stefany-florez/surface-emg-research/README.md

# Surface EMG acquisition and signal analysis

## Overview

## Research question

## Objectives

## System architecture

## Hardware

## Signal processing

## Experimental protocol

## Limitations and future work
