stefany-florez/surface-emg-research/hardware/README.md

# Hardware
This section documents the hardware developed for the surface EMG acquisition system.

## Current system

The current prototype is a surface EMG acquisition system designed to capture the electrical activity generated by forearm muscles during voluntary contraction.

The system consists of surface electrodes, an instrumentation amplifier, analog sinal conditioning stages, and a microcontroller-based data acquisition stage.

The acquired signal is currently monitored using an Arduino-based acquisition system and an oscilloscope for hardware validation.

### Circuit schematic

The following schematic represents the current hardware implementation (v0.1).

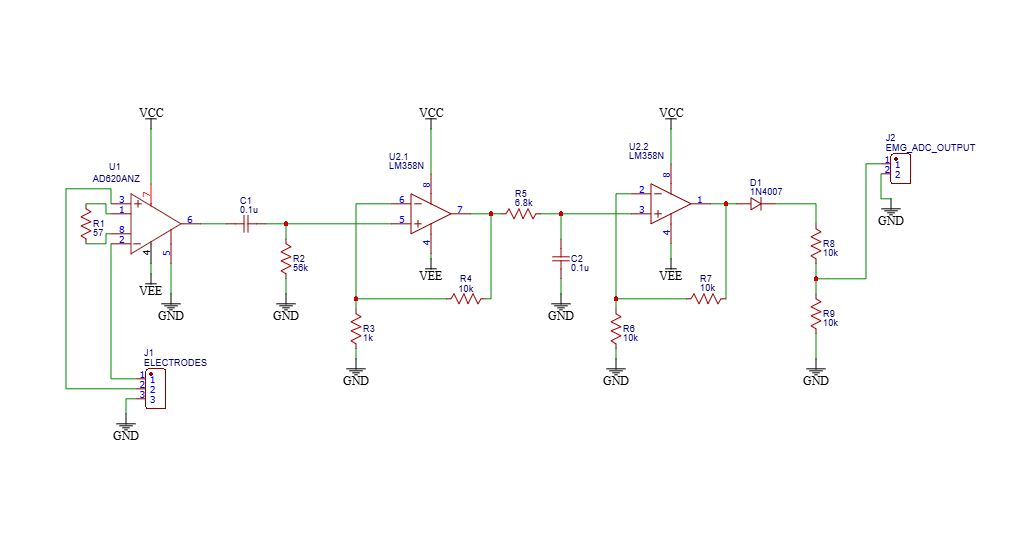
[picture p1: hardware/schematic/surface_emg_v0.1.png]
Surface EMG acquisition system schematic


## Signal acquisition

The surface EMG signal is acquired using a differential configuration. The voltage difference between two electrodes placed over the forearm muscle is provided to the differential inputs of the instrumentation amplifier.

## Electrode configuration

Two electrodes were placed over a forearm muscle to record the differential EMG signal. A third electrode was placed near the elbow and connected to the circuit ground.

Surface EMG electrode configuration


## Instrumentation amplifier

The AD620 instrumentation amplifier is used as the first amplification stage. The two surface electrodes are connected to its differential inputs, while a 57 Ω resistor is used to set the amplifier gain.

The gain of the AD620 is determined by the external gain resistor:

$$
G = 1 + \frac{49.4\,k\Omega}{R_G}
$$

For the prototype, $R_G = 57\,\Omega$, resulting in:

$$
G = 1 + \frac{49.4\,k\Omega}{57\,\Omega} \approx 868
$$

## Analog filtering and signal conditioning

The amplified signal from the AD620 is AC-coupled by C1 and R2 to attenuate the DC component and very low-frequency variations and baseline fluctuations, caused changes in electrode-skin impedance, perspiration or cable movement. With C1 = 0.1 µF and R2 = 56 kΩ, the theoretical cutoff frequency is approximately 28.4 Hz.

After the initial filtering from the high-pass filter, the signal is amplified by the first LM358 with a theoretical gain of 11. 

The resulting amplified signal then passes through a low-pass filter formed by R5 = 6.8 kΩ and C2 = 0.1 µF with a theoretical cutoff frequency of approximately 234 Hz, attenuating high-frequency noise and interference.

The second LM358 stage provides additional non-inverting amplification to the analog-filtered signal with a gain of 2. The amplified signal is then half-wave rectified by a 1N4007 diode. Finally, a resistive voltage divider scales the signal before it is connected to the ADC input.

## Power supply

The prototype is powered by two 9 V batteries configured as a bipolar supply. The circuit uses VCC, VEE, and GND as the positive supply, negative supply, and common reference, respectively.

## Hardware validation

A breadboard prototype was assembled and experimentally tested to verify the signal acquisition and analog signal-conditioning stages.

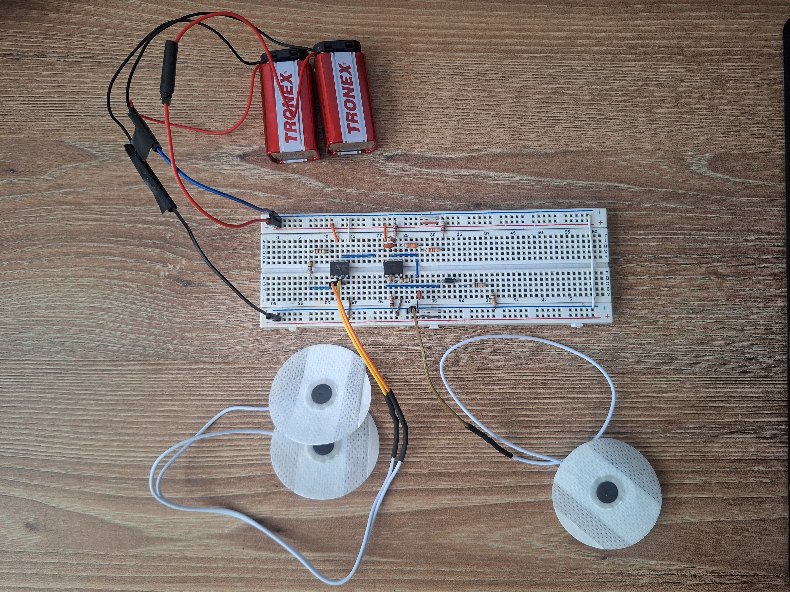
[picture p3: hardware/images/prototype_v0.1_breadboard.jpg]
Surface EMG breadboard prototype


The amplification and rectification stages were experimentally evaluated using an oscilloscope. The corresponding measurements are documented in the [amplification](measurements/prototype_v0.1/amplification.md) and [rectification](measurements/prototype_v0.1/rectification.md) experiment records.

The voltage-divider output was also measured during voluntary forearm muscle contraction. The output showed a half-wave rectified waveform with a measured peak-to-peak voltage of 3.91 V.
