stefany-florez/surface-emg-research/data/processed/figures/emg_contraction_20260922_202403_100ms.png

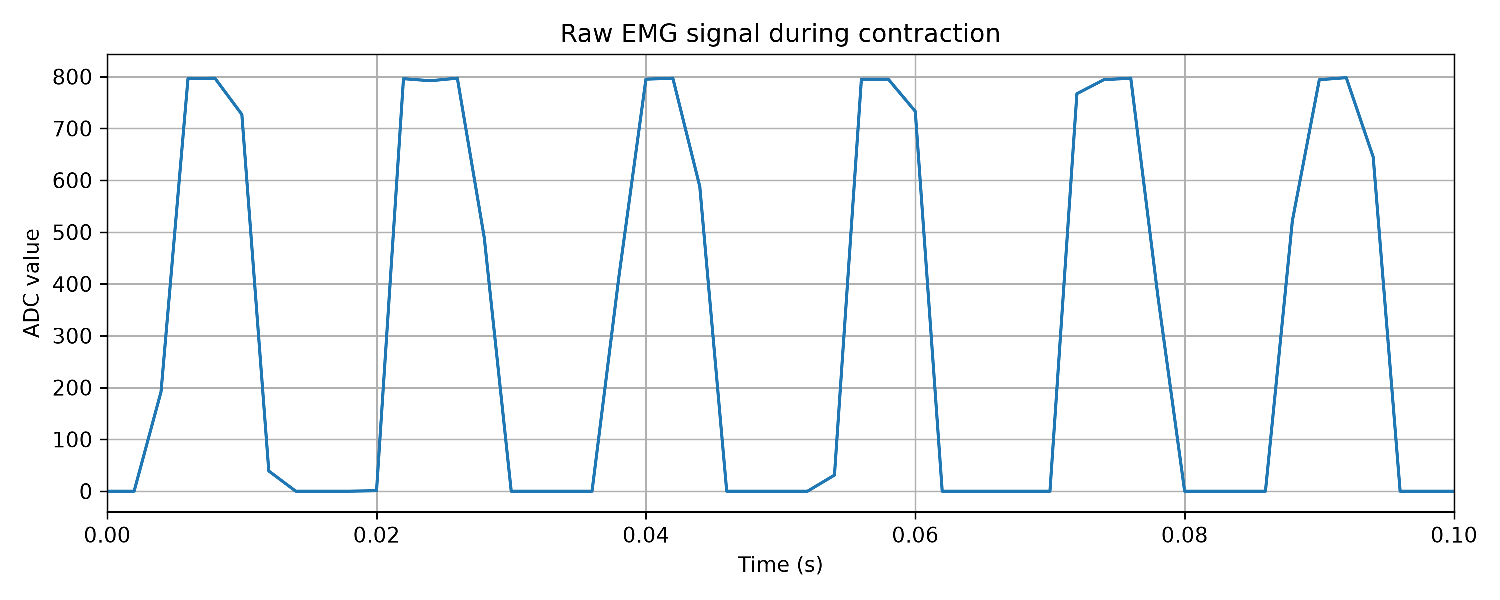
data/processed/figures/emg_contraction_20260922_202403_100ms.png
