stefany-florez/surface-emg-research/data/processed/figures/emg_contraction_20260922_202403_full.png

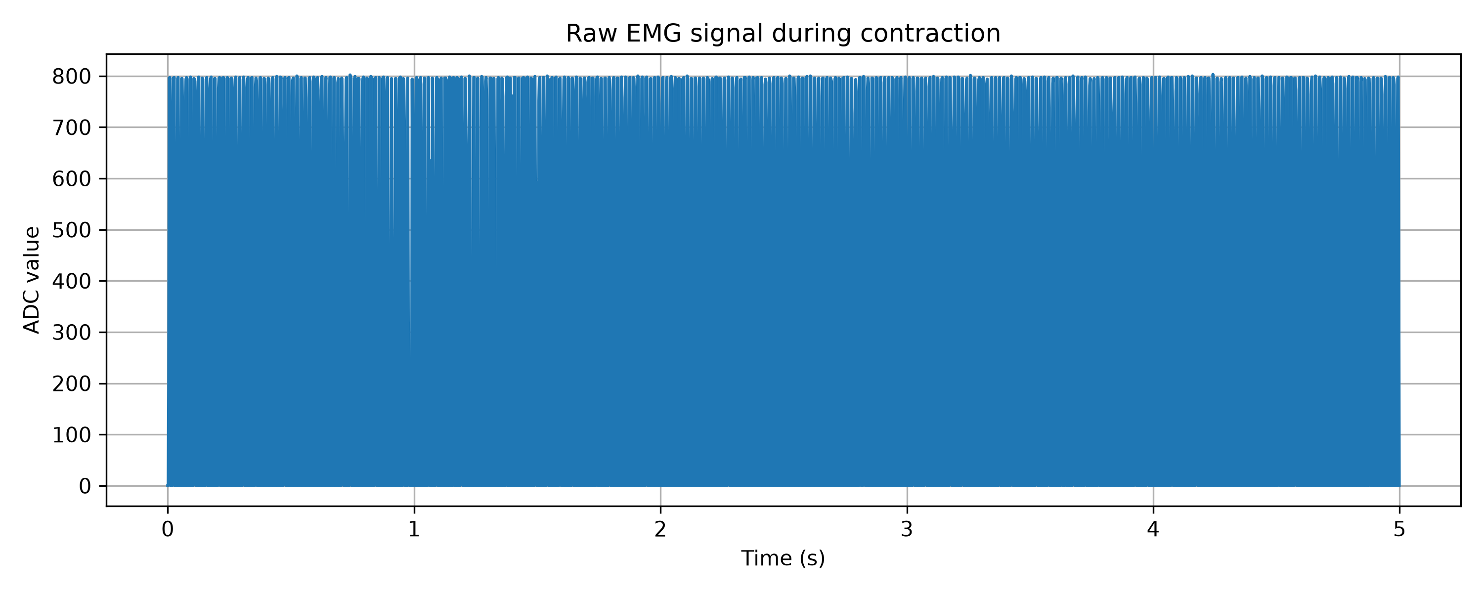
data/processed/figures/emg_contraction_20260922_202403_full.png
