stefany-florez/surface-emg-research/data/processed/figures/emg_rest_20260922_202220_100ms.png

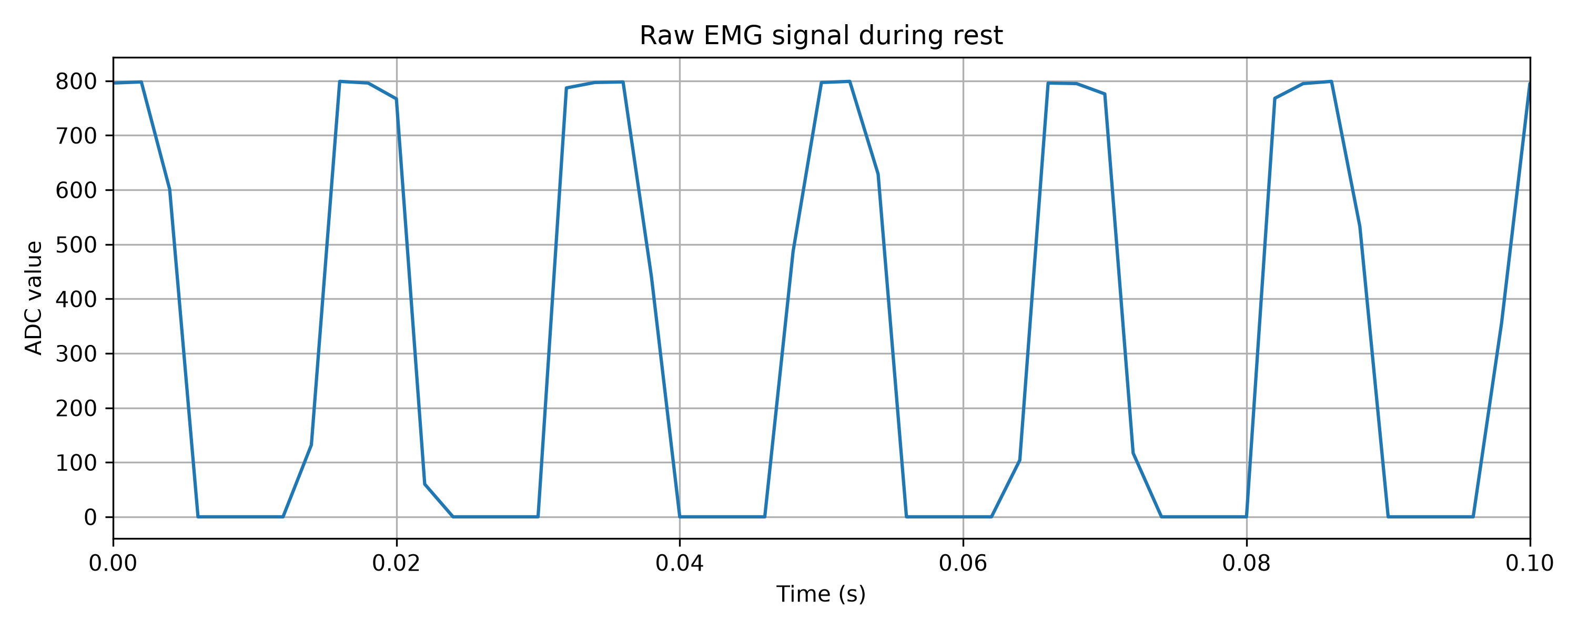
data/processed/figures/emg_rest_20260922_202220_100ms.png
