stefany-florez/surface-emg-research/data/processed/figures/emg_rest_20260922_202220_full.png

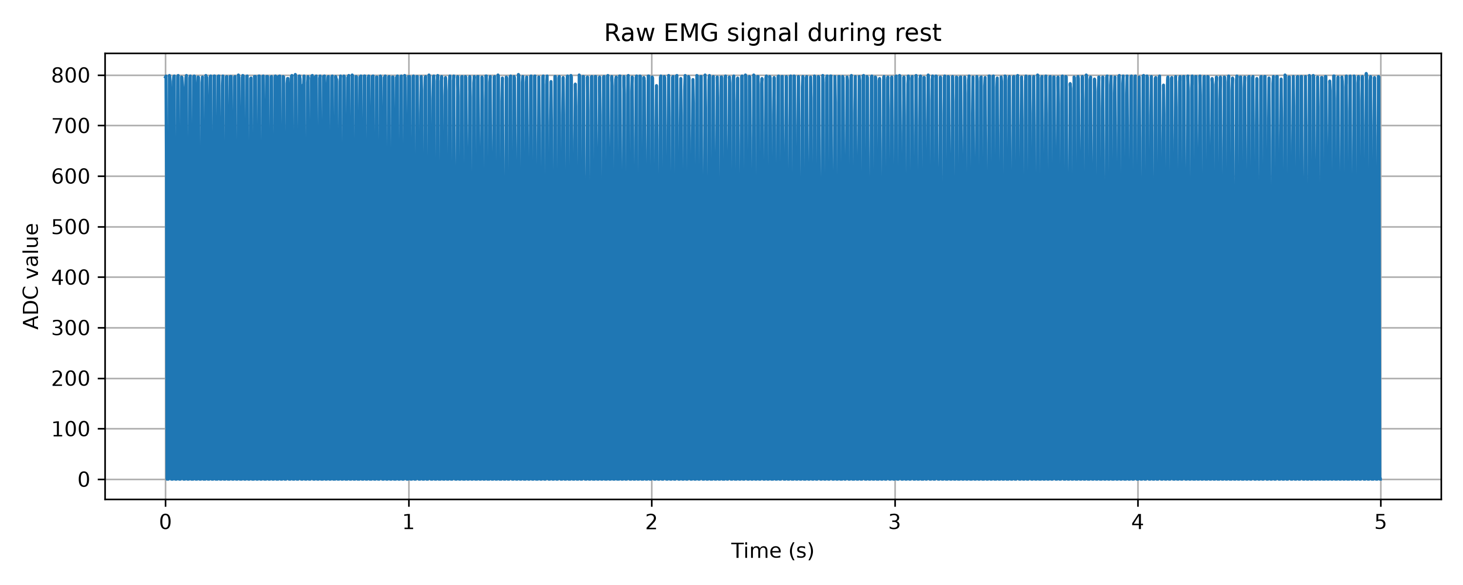
data/processed/figures/emg_rest_20260922_202220_full.png
