stefany-florez/surface-emg-research/hardware/schematic/surface_emg_v0.1.pdf

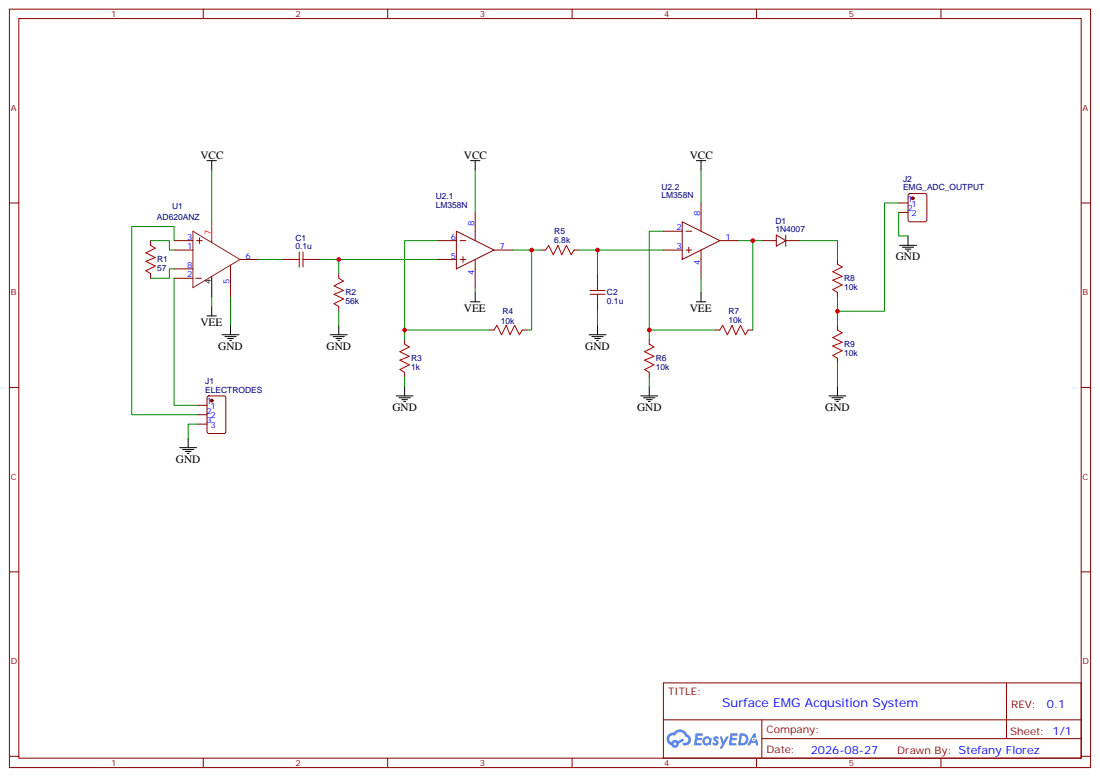
[picture p8: page 1]

Drawn By: Stefany Florez
