stefany-florez/surface-emg-research/hardware/measurements/prototype_v0.1/figures/amplification_trial_05.png

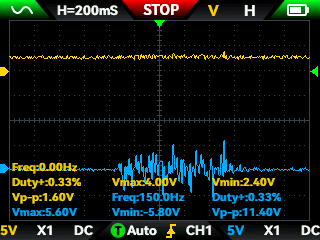
hardware/measurements/prototype_v0.1/figures/amplification_trial_05.png
