stefany-florez/surface-emg-research/hardware/measurements/prototype_v0.1/figures/rectification_trial_02.png

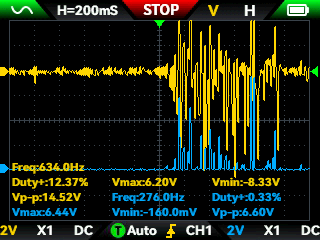
hardware/measurements/prototype_v0.1/figures/rectification_trial_02.png
