stefany-florez/surface-emg-research/(commit log)

2026-08-29 docs(hardware): add hardware documentation and schematic
2026-09-23 feat(acquisition): add EMG data acquisition and raw recordings
    [emg_contraction_20260922_202403.csv, emg_rest_20260922_202220.csv]
