stefany-florez/surface-emg-research/hardware/images/electrode_placement.jpg

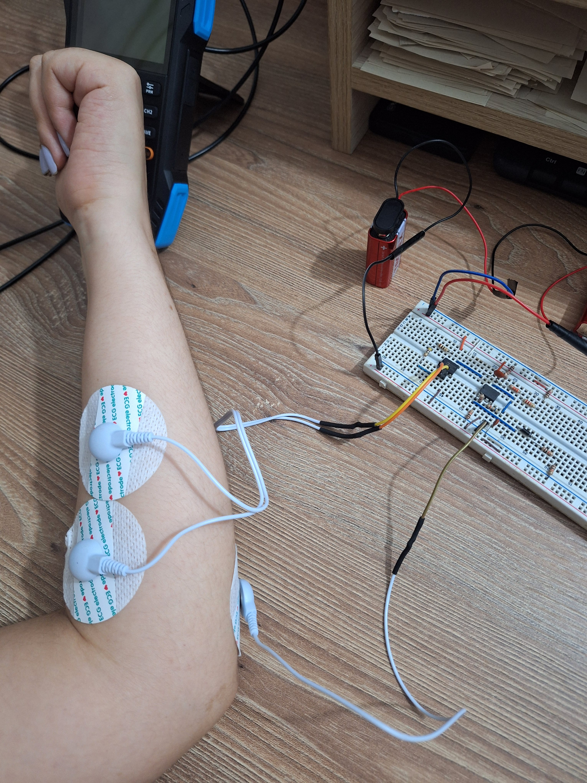
[picture p2: hardware/images/electrode_placement.jpg]
hardware/images/electrode_placement.jpg
